aorgazf/cbm4032_rpi/Hardware - REV03F/CBM4032_Pi4_Pi5_IEEE488_REV03.kicad_pcb

## KiCad design Hardware - REV03F/CBM4032_Pi4_Pi5_IEEE488_REV03.kicad_pcb (2026-10-24, last stored version)

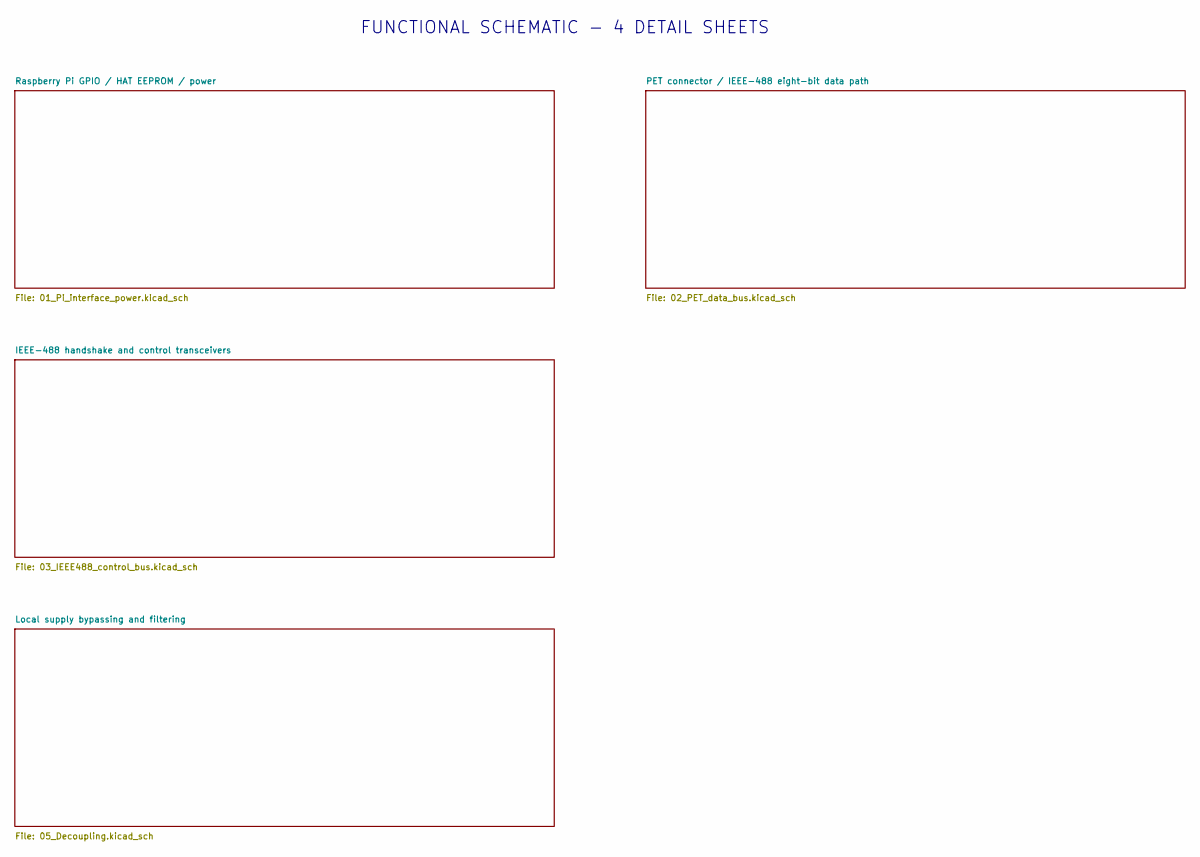
[picture p1: schematic CBM4032_Pi4_Pi5_IEEE488_REV03.kicad_sch, CBM 4032/Pi4B/Pi5 IEEE-488 HAT]

Notes on the sheet:
FUNCTIONAL SCHEMATIC - 4 DETAIL SHEETS

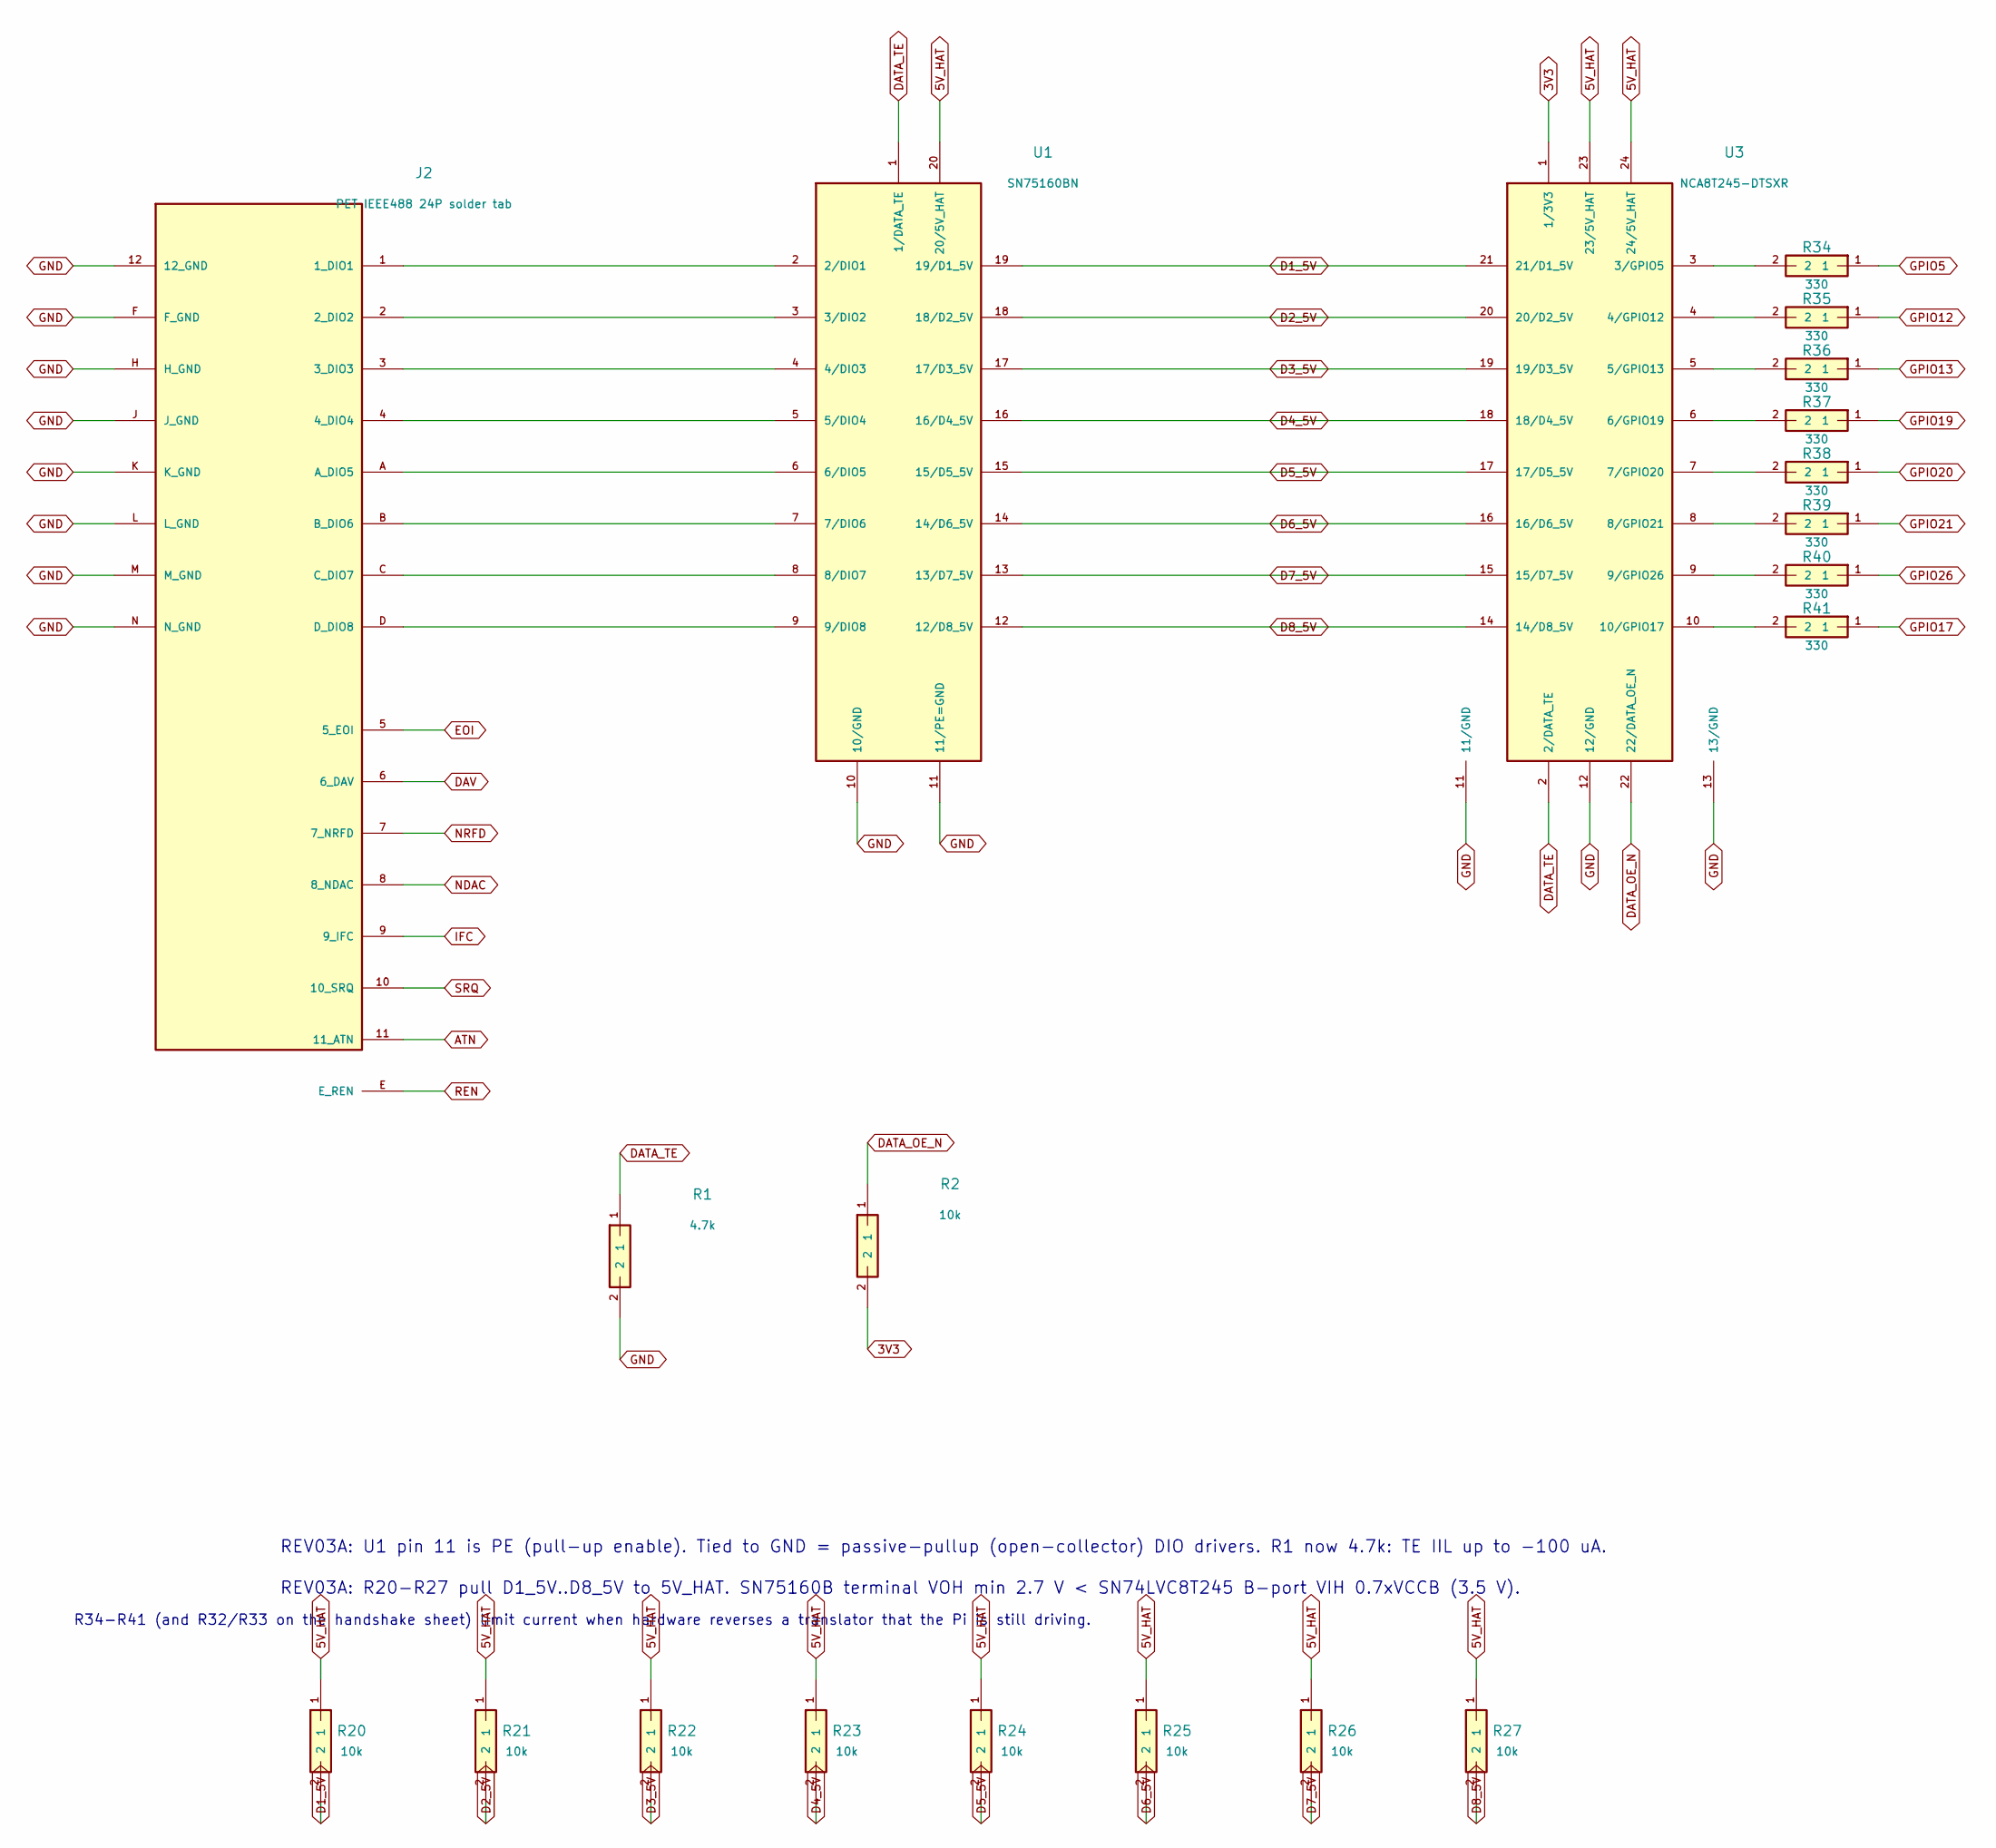
[picture p2: schematic 02_PET_data_bus.kicad_sch, CBM4032 <-> Raspberry Pi IEEE-488 HAT]

Parts:
J2: PET IEEE488 24P solder tab; J2
R1: 4.7k; R0805; MPN 0805W8F4701T5E; LCSC C17673
R2, R20, R21, R22, R23, R24, R25, R26, R27: 10k; R0805; MPN 0805W8F1002T5E; LCSC C17414
R34, R35, R36, R37, R38, R39, R40, R41: 330; R0805; MPN 0805W8F3300T5E; LCSC C17630
U1: SN75160BN; DIP20; MPN SN75160BN
U3: NCA8T245-DTSXR; TSSOP24; MPN NCA8T245-DTSXR; LCSC C40086844

Connections:
3V3: R2.2, U3.1 (1/3V3); also elsewhere on the board
5V_HAT: R20.1, R21.1, R22.1, R23.1, R24.1, R25.1, R26.1, R27.1, U1.20 (20/5V_HAT), U3.23 (23/5V_HAT), U3.24 (24/5V_HAT); also elsewhere on the board
ATN: J2.11 (11_ATN); also elsewhere on the board
D1_5V: R20.2, U1.19 (19/D1_5V), U3.21 (21/D1_5V)
D2_5V: R21.2, U1.18 (18/D2_5V), U3.20 (20/D2_5V)
D3_5V: R22.2, U1.17 (17/D3_5V), U3.19 (19/D3_5V)
D4_5V: R23.2, U1.16 (16/D4_5V), U3.18 (18/D4_5V)
D5_5V: R24.2, U1.15 (15/D5_5V), U3.17 (17/D5_5V)
D6_5V: R25.2, U1.14 (14/D6_5V), U3.16 (16/D6_5V)
D7_5V: R26.2, U1.13 (13/D7_5V), U3.15 (15/D7_5V)
D8_5V: R27.2, U1.12 (12/D8_5V), U3.14 (14/D8_5V)
DATA_OE_N: R2.1, U3.22 (22/DATA_OE_N); also elsewhere on the board
DATA_TE: R1.1, U1.1 (1/DATA_TE), U3.2 (2/DATA_TE); also elsewhere on the board
DAV: J2.6 (6_DAV); also elsewhere on the board
EOI: J2.5 (5_EOI); also elsewhere on the board
GND: J2.12 (12_GND), J2.F (F_GND), J2.H (H_GND), J2.J (J_GND), J2.K (K_GND), J2.L (L_GND), J2.M (M_GND), J2.N (N_GND), R1.2, U1.10 (10/GND), U1.11 (11/PE=GND), U3.11 (11/GND), U3.12 (12/GND), U3.13 (13/GND); also elsewhere on the board
GPIO5: R34.1; also elsewhere on the board
GPIO12: R35.1; also elsewhere on the board
GPIO13: R36.1; also elsewhere on the board
GPIO17: R41.1; also elsewhere on the board
GPIO19: R37.1; also elsewhere on the board
GPIO20: R38.1; also elsewhere on the board
GPIO21: R39.1; also elsewhere on the board
GPIO26: R40.1; also elsewhere on the board
IFC: J2.9 (9_IFC); also elsewhere on the board
NDAC: J2.8 (8_NDAC); also elsewhere on the board
NRFD: J2.7 (7_NRFD); also elsewhere on the board
unnamed: J2.1 (1_DIO1), U1.2 (2/DIO1)
unnamed: J2.2 (2_DIO2), U1.3 (3/DIO2)
unnamed: J2.3 (3_DIO3), U1.4 (4/DIO3)
unnamed: J2.4 (4_DIO4), U1.5 (5/DIO4)
unnamed: J2.A (A_DIO5), U1.6 (6/DIO5)
unnamed: J2.B (B_DIO6), U1.7 (7/DIO6)
unnamed: J2.C (C_DIO7), U1.8 (8/DIO7)
unnamed: J2.D (D_DIO8), U1.9 (9/DIO8)
unnamed: R34.2, U3.3 (3/GPIO5)
unnamed: R35.2, U3.4 (4/GPIO12)
unnamed: R36.2, U3.5 (5/GPIO13)
unnamed: R37.2, U3.6 (6/GPIO19)
unnamed: R38.2, U3.7 (7/GPIO20)
unnamed: R39.2, U3.8 (8/GPIO21)
unnamed: R40.2, U3.9 (9/GPIO26)
unnamed: R41.2, U3.10 (10/GPIO17)
REN: J2.E (E_REN); also elsewhere on the board
SRQ: J2.10 (10_SRQ); also elsewhere on the board

Notes on the sheet:
REV03A: R20-R27 pull D1_5V..D8_5V to 5V_HAT. SN75160B terminal VOH min 2.7 V < SN74LVC8T245 B-port VIH 0.7xVCCB (3.5 V).
R34-R41 (and R32/R33 on the handshake sheet) limit current when hardware reverses a translator that the Pi is still driving.
REV03A: U1 pin 11 is PE (pull-up enable). Tied to GND = passive-pullup (open-collector) DIO drivers. R1 now 4.7k: TE IIL up to -100 uA.

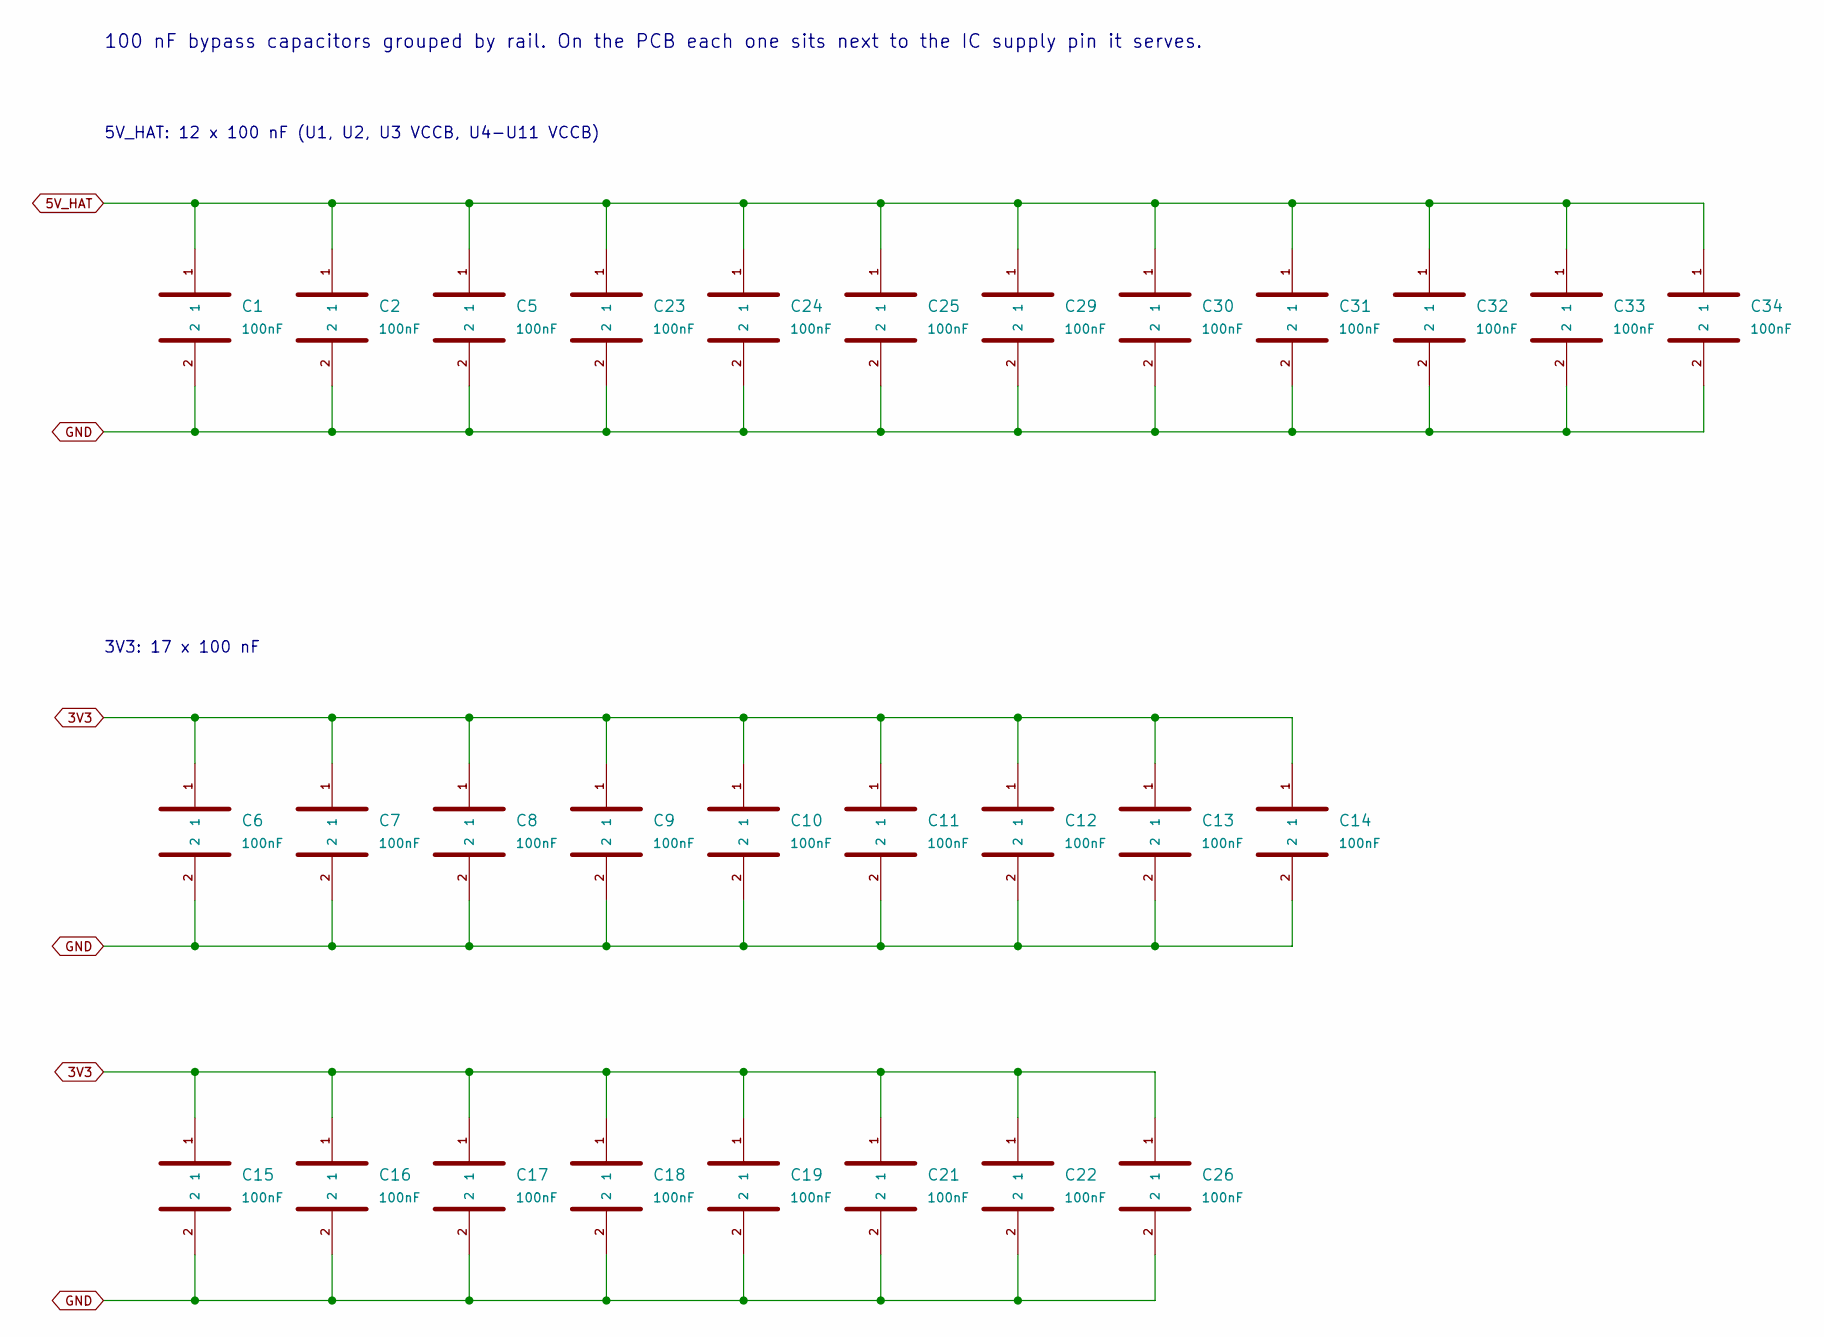
[picture p3: schematic 05_Decoupling.kicad_sch, CBM4032 <-> Raspberry Pi IEEE-488 HAT]

Parts:
C1, C2, C5, C6, C7, C8, C9, C10, C11, C12, C13, C14, C15, C16, C17, C18, C19, C21, C22, C23, C24, C25, C26, C29, C30, C31, C32, C33, C34: 100nF; C0805; MPN CC0805KRX7R9BB104; LCSC C49678

Connections:
3V3: C6.1, C7.1, C8.1, C9.1, C10.1, C11.1, C12.1, C13.1, C14.1, C15.1, C16.1, C17.1, C18.1, C19.1, C21.1, C22.1, C26.1; also elsewhere on the board
5V_HAT: C1.1, C2.1, C5.1, C23.1, C24.1, C25.1, C29.1, C30.1, C31.1, C32.1, C33.1, C34.1; also elsewhere on the board
GND: C1.2, C2.2, C5.2, C6.2, C7.2, C8.2, C9.2, C10.2, C11.2, C12.2, C13.2, C14.2, C15.2, C16.2, C17.2, C18.2, C19.2, C21.2, C22.2, C23.2, C24.2, C25.2, C26.2, C29.2, C30.2, C31.2, C32.2, C33.2, C34.2; also elsewhere on the board

Notes on the sheet:
5V_HAT: 12 x 100 nF (U1, U2, U3 VCCB, U4-U11 VCCB)
100 nF bypass capacitors grouped by rail. On the PCB each one sits next to the IC supply pin it serves.
3V3: 17 x 100 nF

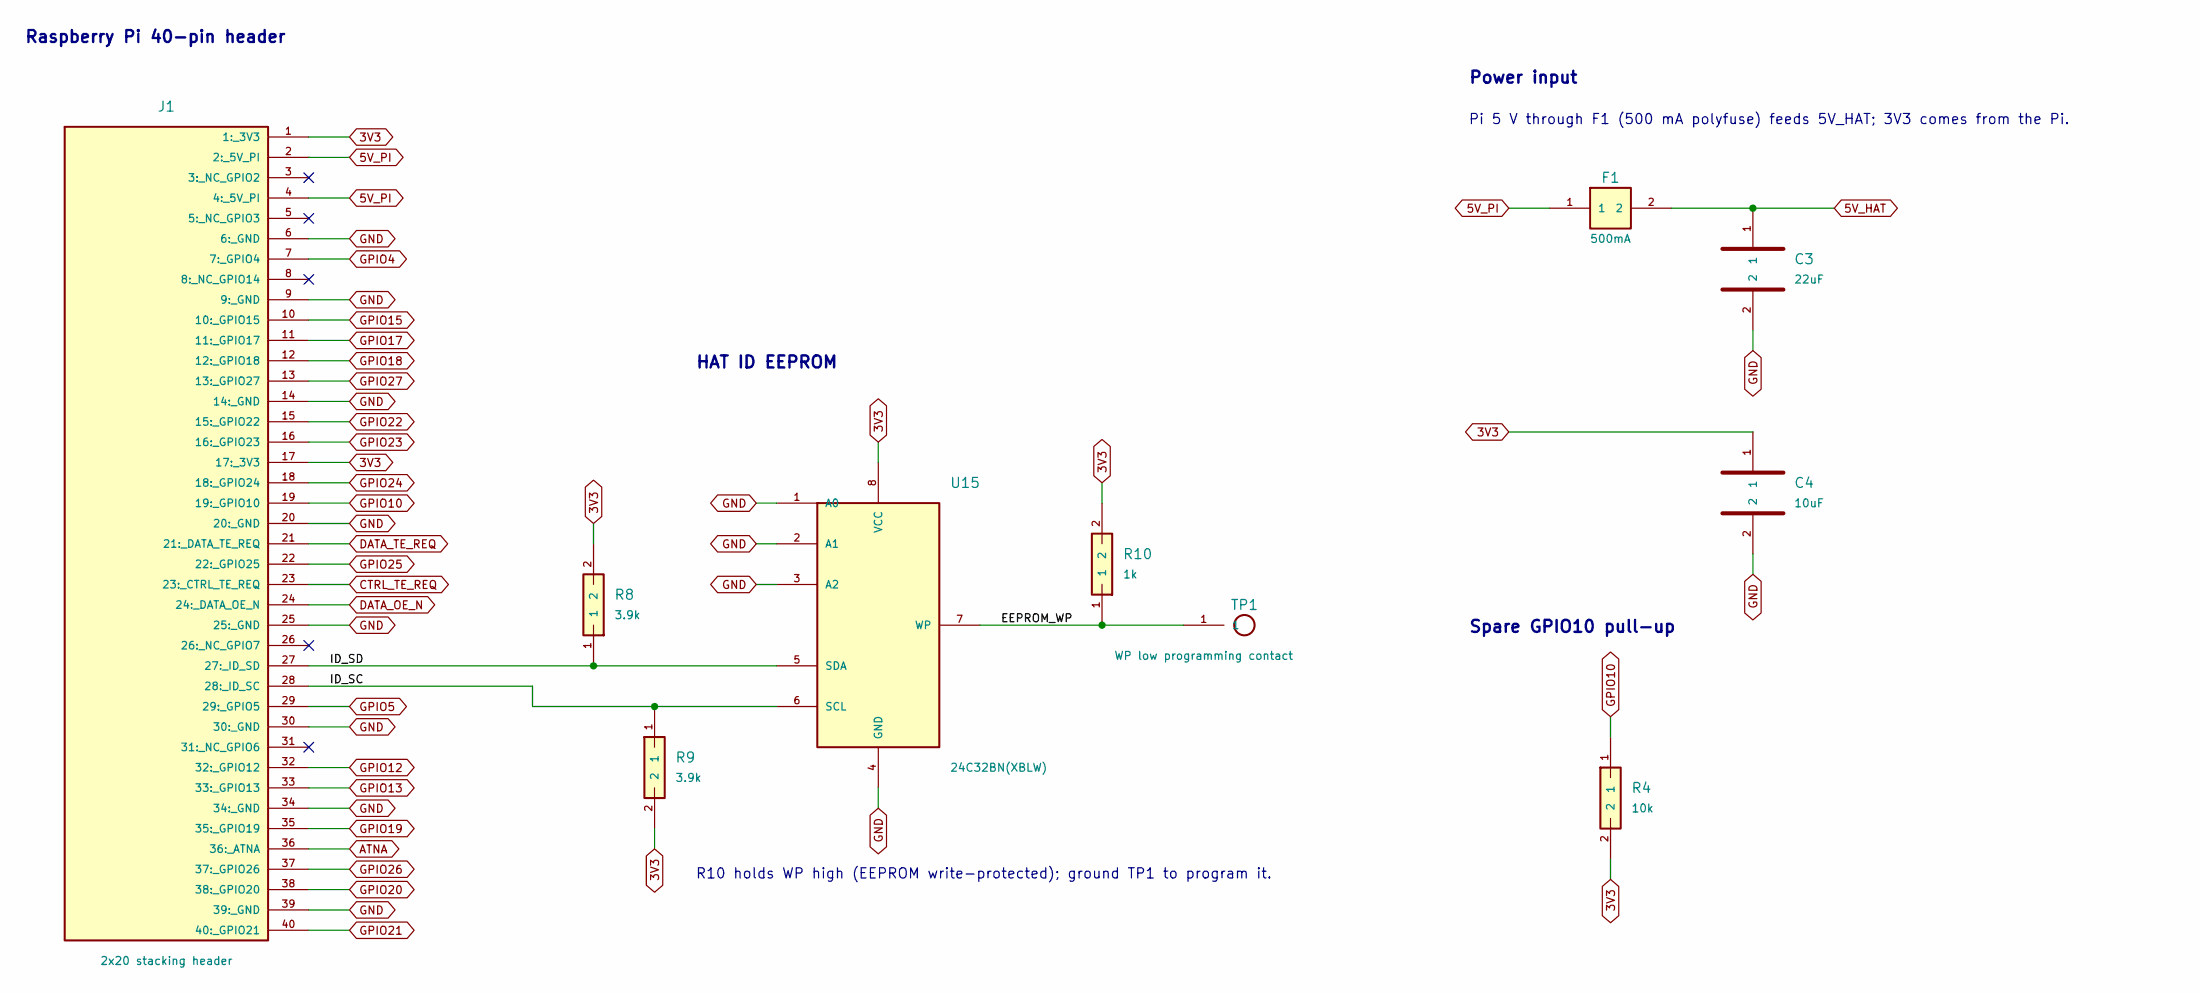
[picture p4: schematic 01_Pi_interface_power.kicad_sch, CBM4032 <-> Raspberry Pi IEEE-488 HAT]

Parts:
C3: 22uF; C1206; MPN CL31A226KAHNNNE; LCSC C12891
C4: 10uF; C0805; MPN CL21A106KAYNNNE; LCSC C15850
F1: 500mA; R1206; MPN 1206L050/6NR; LCSC C7542942
J1: 2x20 stacking header; J1
R4: 10k; R0805; MPN 0805W8F1002T5E; LCSC C17414
R8, R9: 3.9k; R0805; MPN 0805W8F3901T5E; LCSC C17614
R10: 1k; R0805; MPN 0805W8F1001T5E; LCSC C17513
TP1: WP low programming contact; TP
U15: 24C32BN(XBLW); SOP8; MPN 24C32BN(XBLW); LCSC C18723546

Connections:
3V3: C4.1, J1.1 (1:_3V3), J1.17 (17:_3V3), R4.2, R8.2, R9.2, R10.2, U15.8 (VCC); also elsewhere on the board
5V_HAT: C3.1, F1.2; also elsewhere on the board
5V_PI: F1.1, J1.2 (2:_5V_PI), J1.4 (4:_5V_PI)
/Raspberry Pi GPIO / HAT EEPROM / power/EEPROM_WP: R10.1, TP1.1 (1_1), U15.7 (WP)
/Raspberry Pi GPIO / HAT EEPROM / power/ID_SC: J1.28 (28:_ID_SC), R9.1, U15.6 (SCL)
/Raspberry Pi GPIO / HAT EEPROM / power/ID_SD: J1.27 (27:_ID_SD), R8.1, U15.5 (SDA)
ATNA: J1.36 (36:_ATNA); also elsewhere on the board
CTRL_TE_REQ: J1.23 (23:_CTRL_TE_REQ); also elsewhere on the board
DATA_OE_N: J1.24 (24:_DATA_OE_N); also elsewhere on the board
DATA_TE_REQ: J1.21 (21:_DATA_TE_REQ); also elsewhere on the board
GND: C3.2, C4.2, J1.6 (6:_GND), J1.9 (9:_GND), J1.14 (14:_GND), J1.20 (20:_GND), J1.25 (25:_GND), J1.30 (30:_GND), J1.34 (34:_GND), J1.39 (39:_GND), U15.1 (A0), U15.2 (A1), U15.3 (A2), U15.4 (GND); also elsewhere on the board
GPIO4: J1.7 (7:_GPIO4); also elsewhere on the board
GPIO5: J1.29 (29:_GPIO5); also elsewhere on the board
GPIO10: J1.19 (19:_GPIO10), R4.1
GPIO12: J1.32 (32:_GPIO12); also elsewhere on the board
GPIO13: J1.33 (33:_GPIO13); also elsewhere on the board
GPIO15: J1.10 (10:_GPIO15); also elsewhere on the board
GPIO17: J1.11 (11:_GPIO17); also elsewhere on the board
GPIO18: J1.12 (12:_GPIO18); also elsewhere on the board
GPIO19: J1.35 (35:_GPIO19); also elsewhere on the board
GPIO20: J1.38 (38:_GPIO20); also elsewhere on the board
GPIO21: J1.40 (40:_GPIO21); also elsewhere on the board
GPIO22: J1.15 (15:_GPIO22); also elsewhere on the board
GPIO23: J1.16 (16:_GPIO23); also elsewhere on the board
GPIO24: J1.18 (18:_GPIO24); also elsewhere on the board
GPIO25: J1.22 (22:_GPIO25); also elsewhere on the board
GPIO26: J1.37 (37:_GPIO26); also elsewhere on the board
GPIO27: J1.13 (13:_GPIO27); also elsewhere on the board

Notes on the sheet:
Pi 5 V through F1 (500 mA polyfuse) feeds 5V_HAT; 3V3 comes from the Pi.
Spare GPIO10 pull-up
R10 holds WP high (EEPROM write-protected); ground TP1 to program it.
Raspberry Pi 40-pin header
Power input
HAT ID EEPROM
