aorgazf/cbm4032_rpi/Hardware - REV03F/CBM4032_Pi4_Pi5_IEEE488_REV03.kicad_pcb

## KiCad design Hardware - REV03F/CBM4032_Pi4_Pi5_IEEE488_REV03.kicad_pcb (continued)

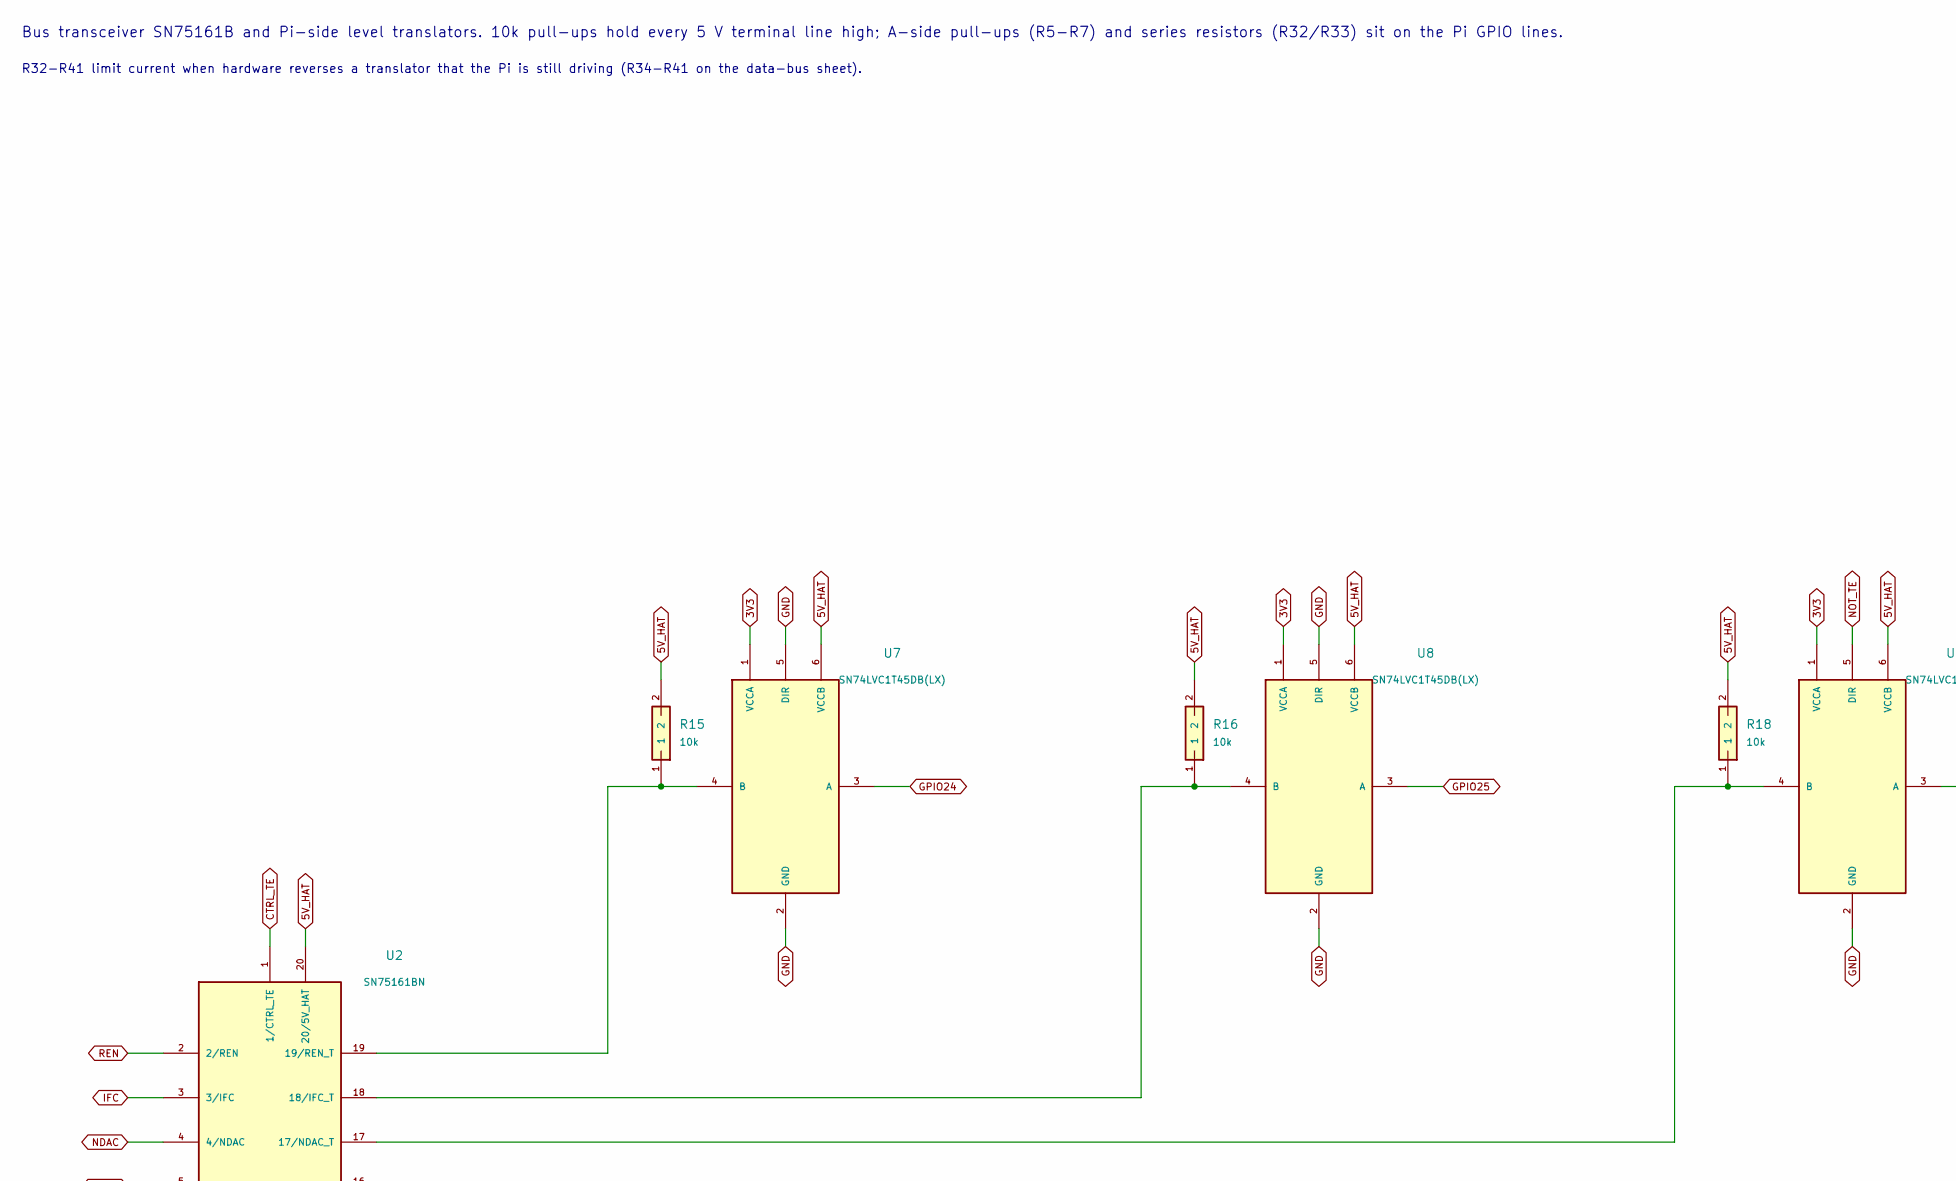
[picture p5: schematic 03_IEEE488_control_bus.kicad_sch, CBM4032 <-> Raspberry Pi IEEE-488 HAT - IEEE-488 handshake …, part in row 1, column 1]

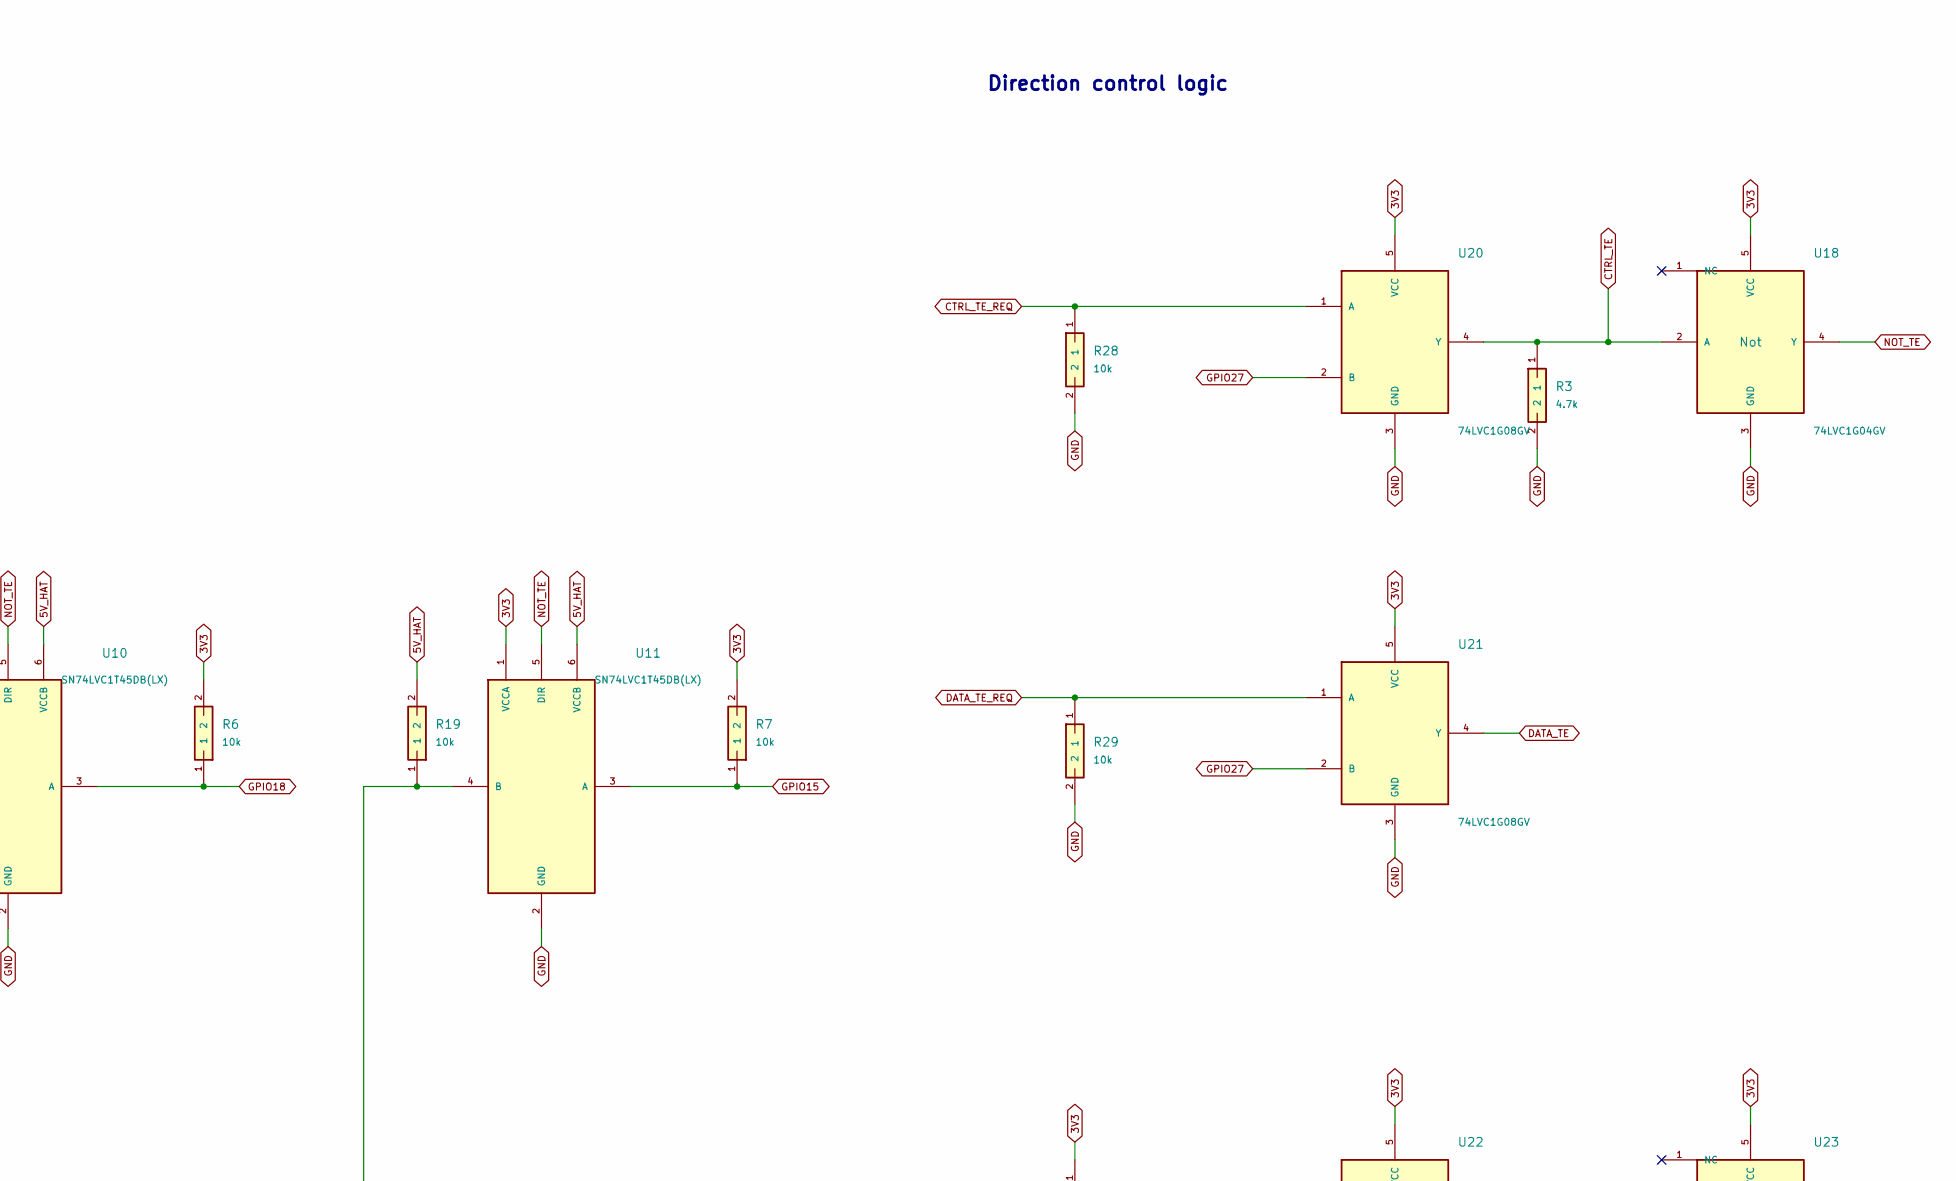
[picture p6: schematic 03_IEEE488_control_bus.kicad_sch, CBM4032 <-> Raspberry Pi IEEE-488 HAT - IEEE-488 handshake …, part in row 1, column 2]

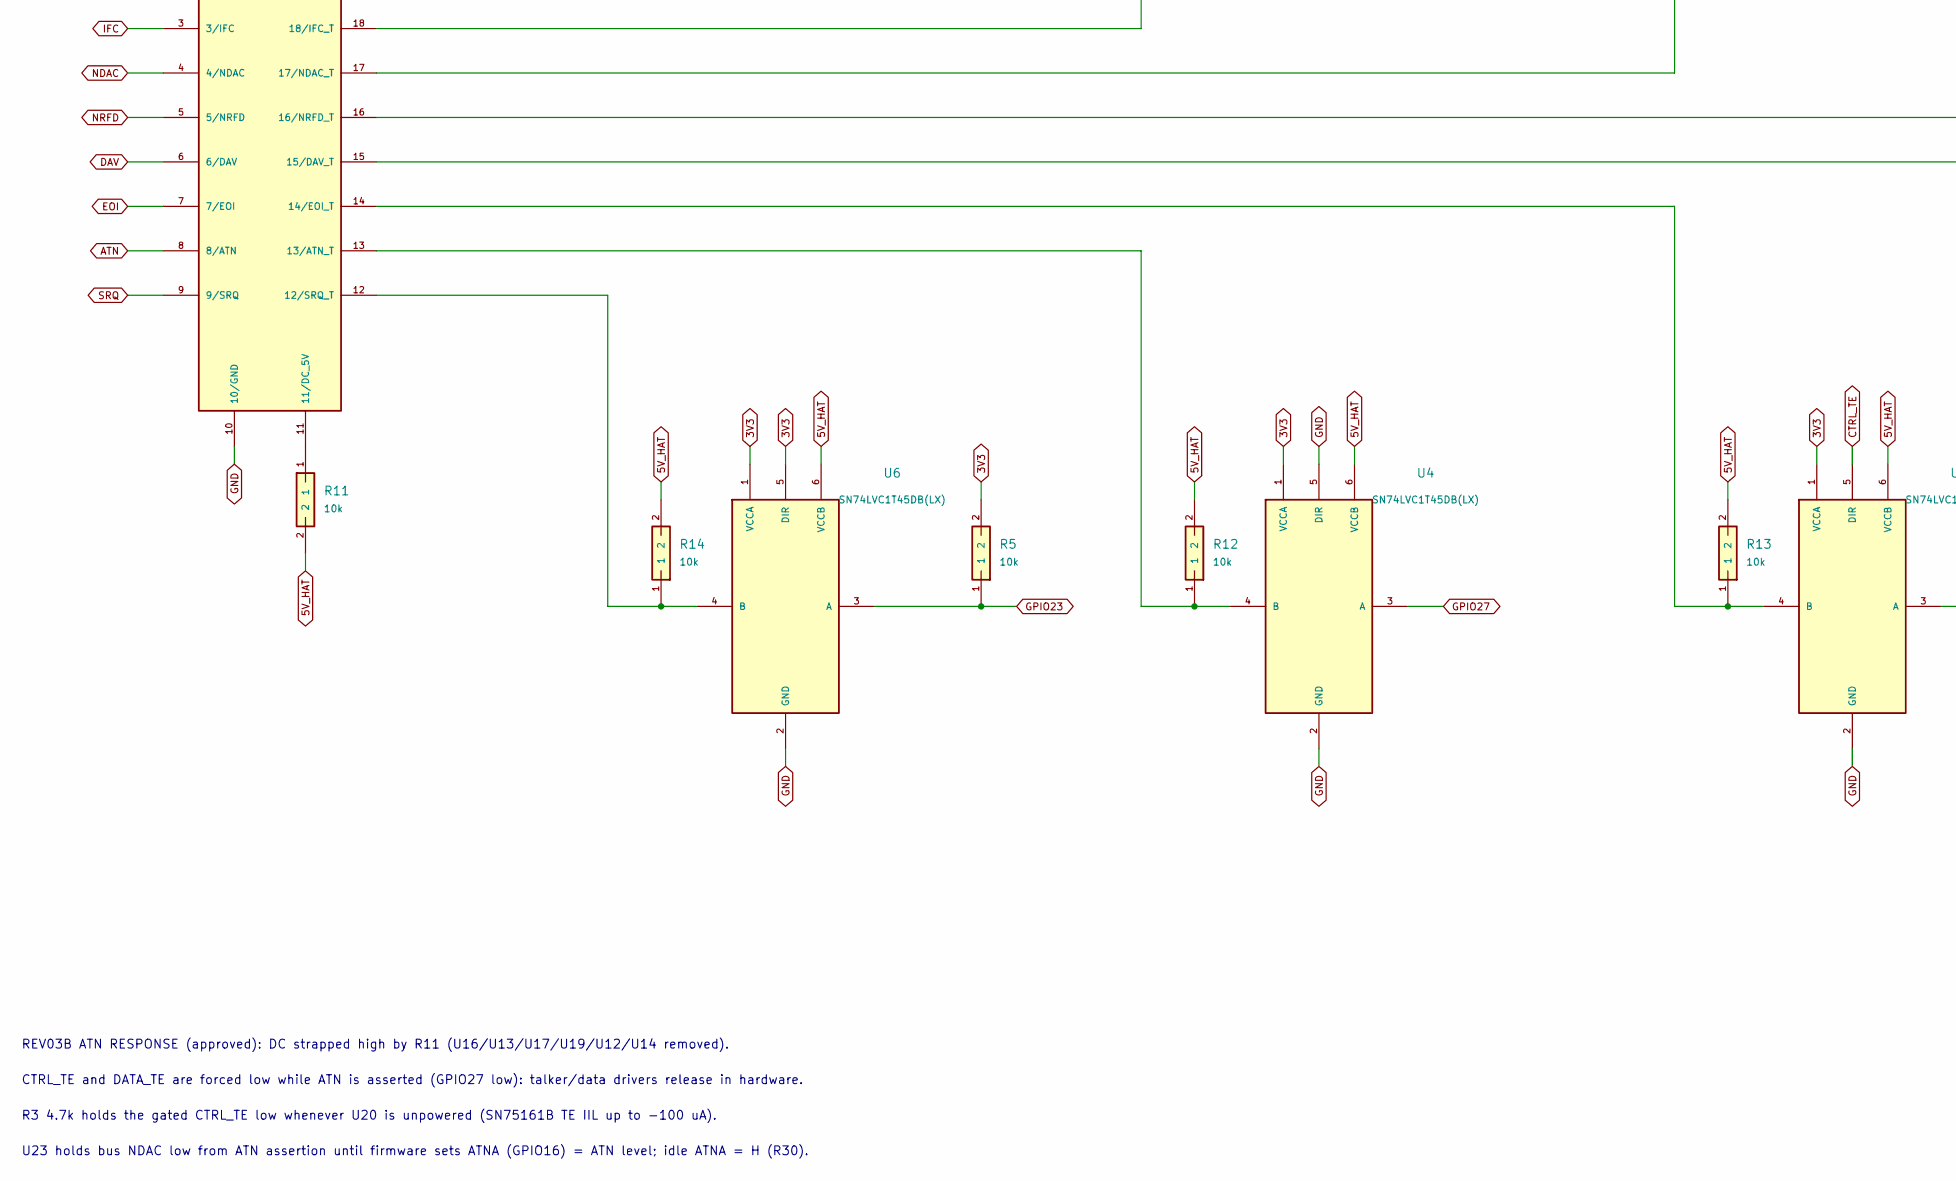
[picture p7: schematic 03_IEEE488_control_bus.kicad_sch, CBM4032 <-> Raspberry Pi IEEE-488 HAT - IEEE-488 handshake …, part in row 2, column 1]

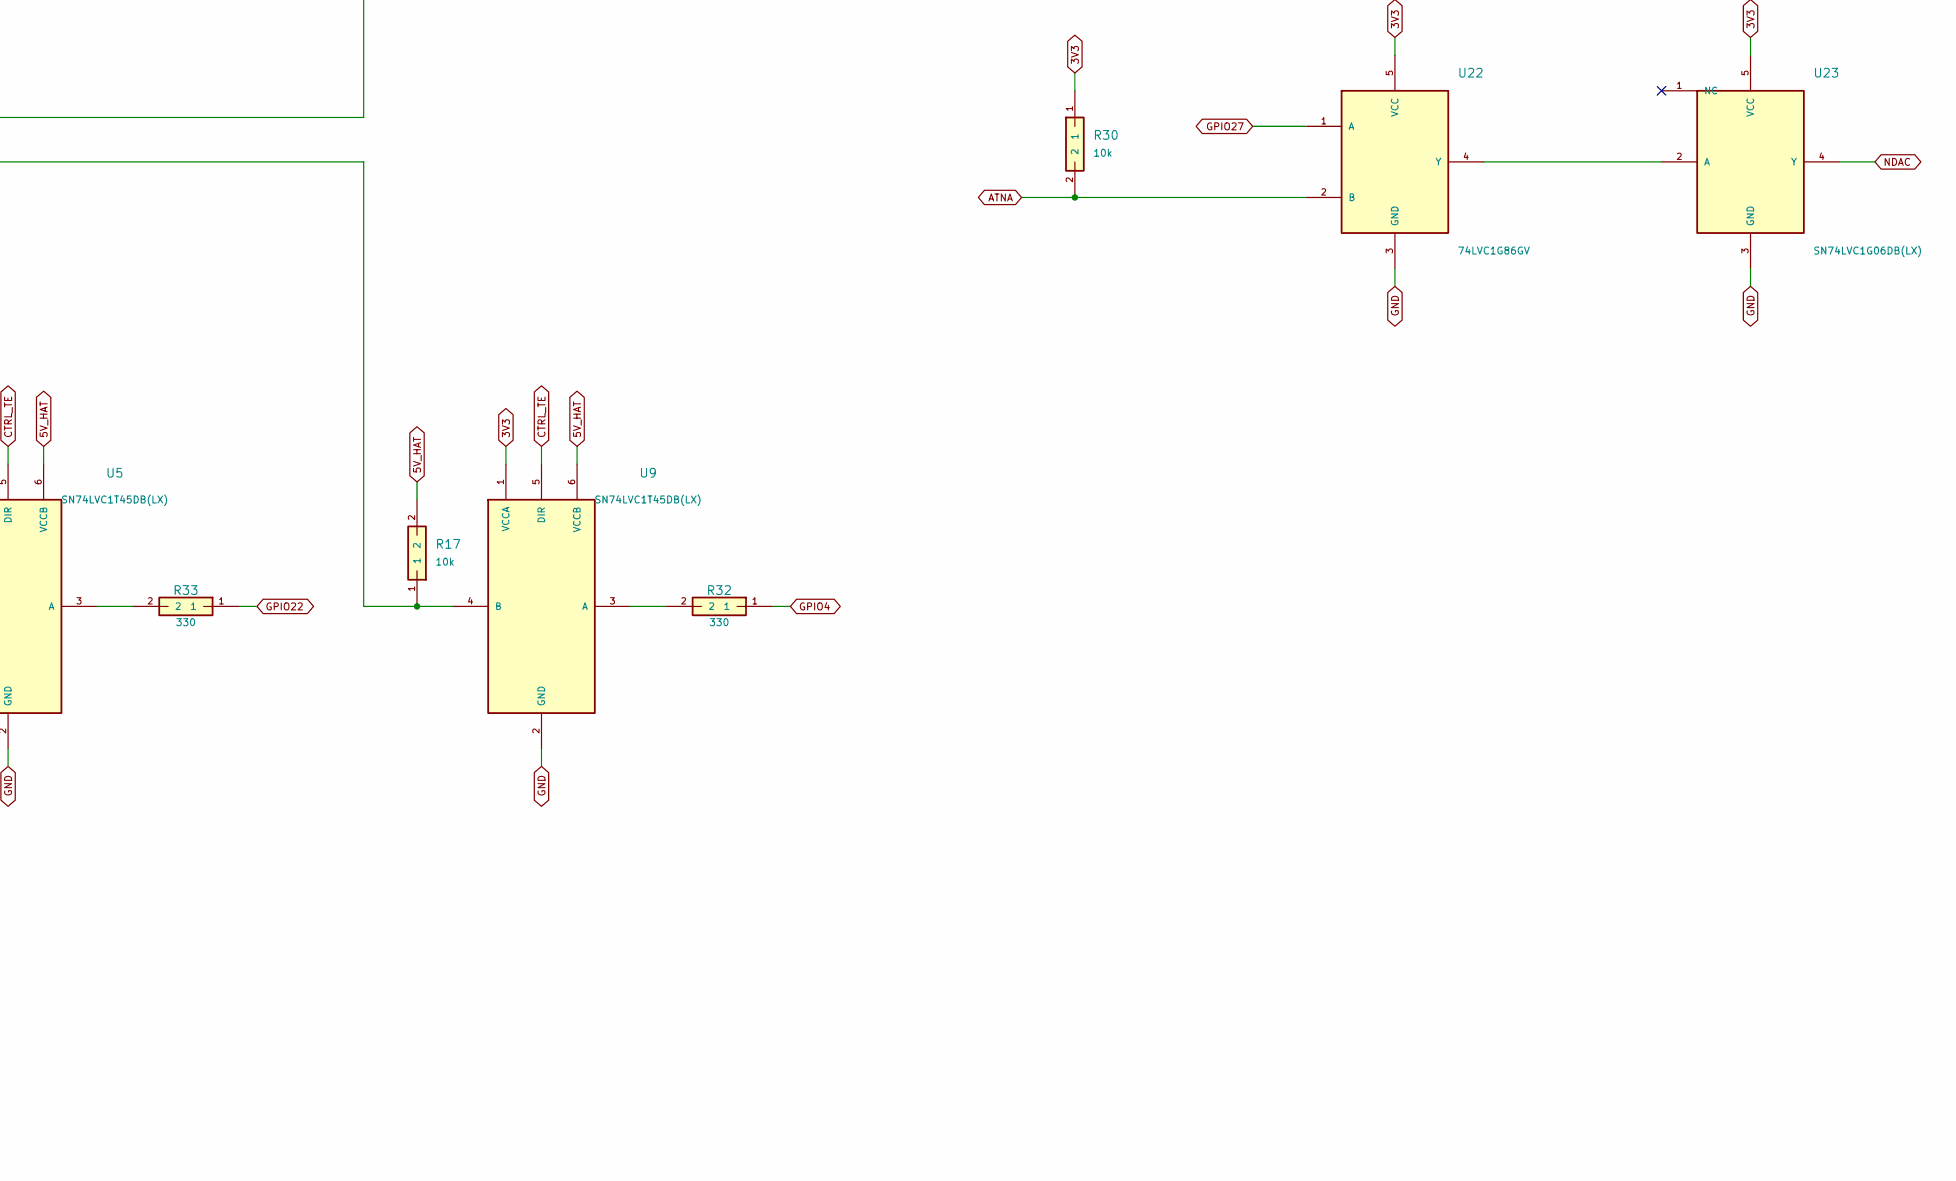
[picture p8: schematic 03_IEEE488_control_bus.kicad_sch, CBM4032 <-> Raspberry Pi IEEE-488 HAT - IEEE-488 handshake …, part in row 2, column 2]

Parts:
R3: 4.7k; R0805; MPN 0805W8F4701T5E; LCSC C17673
R5, R6, R7, R11, R12, R13, R14, R15, R16, R17, R18, R19, R28, R29, R30: 10k; R0805; MPN 0805W8F1002T5E; LCSC C17414
R32, R33: 330; R0805; MPN 0805W8F3300T5E; LCSC C17630
U2: SN75161BN; DIP20; MPN SN75161BN
U4, U5, U6, U7, U8, U9, U10, U11: SN74LVC1T45DB(LX); SOT23_6; MPN SN74LVC1T45DB(LX); LCSC C22469931
U18: 74LVC1G04GV; SOT23_5; MPN 74LVC1G04GV; LCSC C19829589
U20, U21: 74LVC1G08GV; SOT23_5; MPN 74LVC1G08GV; LCSC C19829591
U22: 74LVC1G86GV; SOT23_5; MPN 74LVC1G86GV; LCSC C19829595
U23: SN74LVC1G06DB(LX); SOT23_5; MPN SN74LVC1G06DB(LX); LCSC C22469967

Connections:
3V3: R5.2, R6.2, R7.2, R30.1, U4.1 (VCCA), U5.1 (VCCA), U6.1 (VCCA), U6.5 (DIR), U7.1 (VCCA), U8.1 (VCCA), U9.1 (VCCA), U10.1 (VCCA), U11.1 (VCCA), U18.5 (VCC), U20.5 (VCC), U21.5 (VCC), U22.5 (VCC), U23.5 (VCC); also elsewhere on the board
5V_HAT: R11.2, R12.2, R13.2, R14.2, R15.2, R16.2, R17.2, R18.2, R19.2, U2.20 (20/5V_HAT), U4.6 (VCCB), U5.6 (VCCB), U6.6 (VCCB), U7.6 (VCCB), U8.6 (VCCB), U9.6 (VCCB), U10.6 (VCCB), U11.6 (VCCB); also elsewhere on the board
ATN: U2.8 (8/ATN); also elsewhere on the board
ATNA: R30.2, U22.2 (B); also elsewhere on the board
CTRL_TE: R3.1, U2.1 (1/CTRL_TE), U5.5 (DIR), U9.5 (DIR), U18.2 (A), U20.4 (Y)
CTRL_TE_REQ: R28.1, U20.1 (A); also elsewhere on the board
DATA_TE: U21.4 (Y); also elsewhere on the board
DATA_TE_REQ: R29.1, U21.1 (A); also elsewhere on the board
DAV: U2.6 (6/DAV); also elsewhere on the board
EOI: U2.7 (7/EOI); also elsewhere on the board
GND: R3.2, R28.2, R29.2, U2.10 (10/GND), U4.2 (GND), U4.5 (DIR), U5.2 (GND), U6.2 (GND), U7.2 (GND), U7.5 (DIR), U8.2 (GND), U8.5 (DIR), U9.2 (GND), U10.2 (GND), U11.2 (GND), U18.3 (GND), U20.3 (GND), U21.3 (GND), U22.3 (GND), U23.3 (GND); also elsewhere on the board
GPIO4: R32.1; also elsewhere on the board
GPIO15: R7.1, U11.3 (A); also elsewhere on the board
GPIO18: R6.1, U10.3 (A); also elsewhere on the board
GPIO22: R33.1; also elsewhere on the board
GPIO23: R5.1, U6.3 (A); also elsewhere on the board
GPIO24: U7.3 (A); also elsewhere on the board
GPIO25: U8.3 (A); also elsewhere on the board
GPIO27: U4.3 (A), U20.2 (B), U21.2 (B), U22.1 (A); also elsewhere on the board
IFC: U2.3 (3/IFC); also elsewhere on the board
NDAC: U2.4 (4/NDAC), U23.4 (Y); also elsewhere on the board
NOT_TE: U10.5 (DIR), U11.5 (DIR), U18.4 (Y)
NRFD: U2.5 (5/NRFD); also elsewhere on the board
unnamed: R11.1, U2.11 (11/DC_5V)
unnamed: R14.1, U2.12 (12/SRQ_T), U6.4 (B)
unnamed: R12.1, U2.13 (13/ATN_T), U4.4 (B)
unnamed: R13.1, U2.14 (14/EOI_T), U5.4 (B)
unnamed: R17.1, U2.15 (15/DAV_T), U9.4 (B)
unnamed: R16.1, U2.18 (18/IFC_T), U8.4 (B)
unnamed: R15.1, U2.19 (19/REN_T), U7.4 (B)
unnamed: R33.2, U5.3 (A)
unnamed: R32.2, U9.3 (A)
unnamed: R18.1, U2.17 (17/NDAC_T), U10.4 (B)
unnamed: R19.1, U2.16 (16/NRFD_T), U11.4 (B)
unnamed: U22.4 (Y), U23.2 (A)
REN: U2.2 (2/REN); also elsewhere on the board
SRQ: U2.9 (9/SRQ); also elsewhere on the board

Notes on the sheet:
Bus transceiver SN75161B and Pi-side level translators. 10k pull-ups hold every 5 V terminal line high; A-side pull-ups (R5-R7) and series resistors (R32/R33) sit on the Pi GPIO lines.
R3 4.7k holds the gated CTRL_TE low whenever U20 is unpowered (SN75161B TE IIL up to -100 uA).
REV03B ATN RESPONSE (approved): DC strapped high by R11 (U16/U13/U17/U19/U12/U14 removed).
U23 holds bus NDAC low from ATN assertion until firmware sets ATNA (GPIO16) = ATN level; idle ATNA = H (R30).
Direction control logic
R32-R41 limit current when hardware reverses a translator that the Pi is still driving (R34-R41 on the data-bus sheet).
CTRL_TE and DATA_TE are forced low while ATN is asserted (GPIO27 low): talker/data drivers release in hardware.

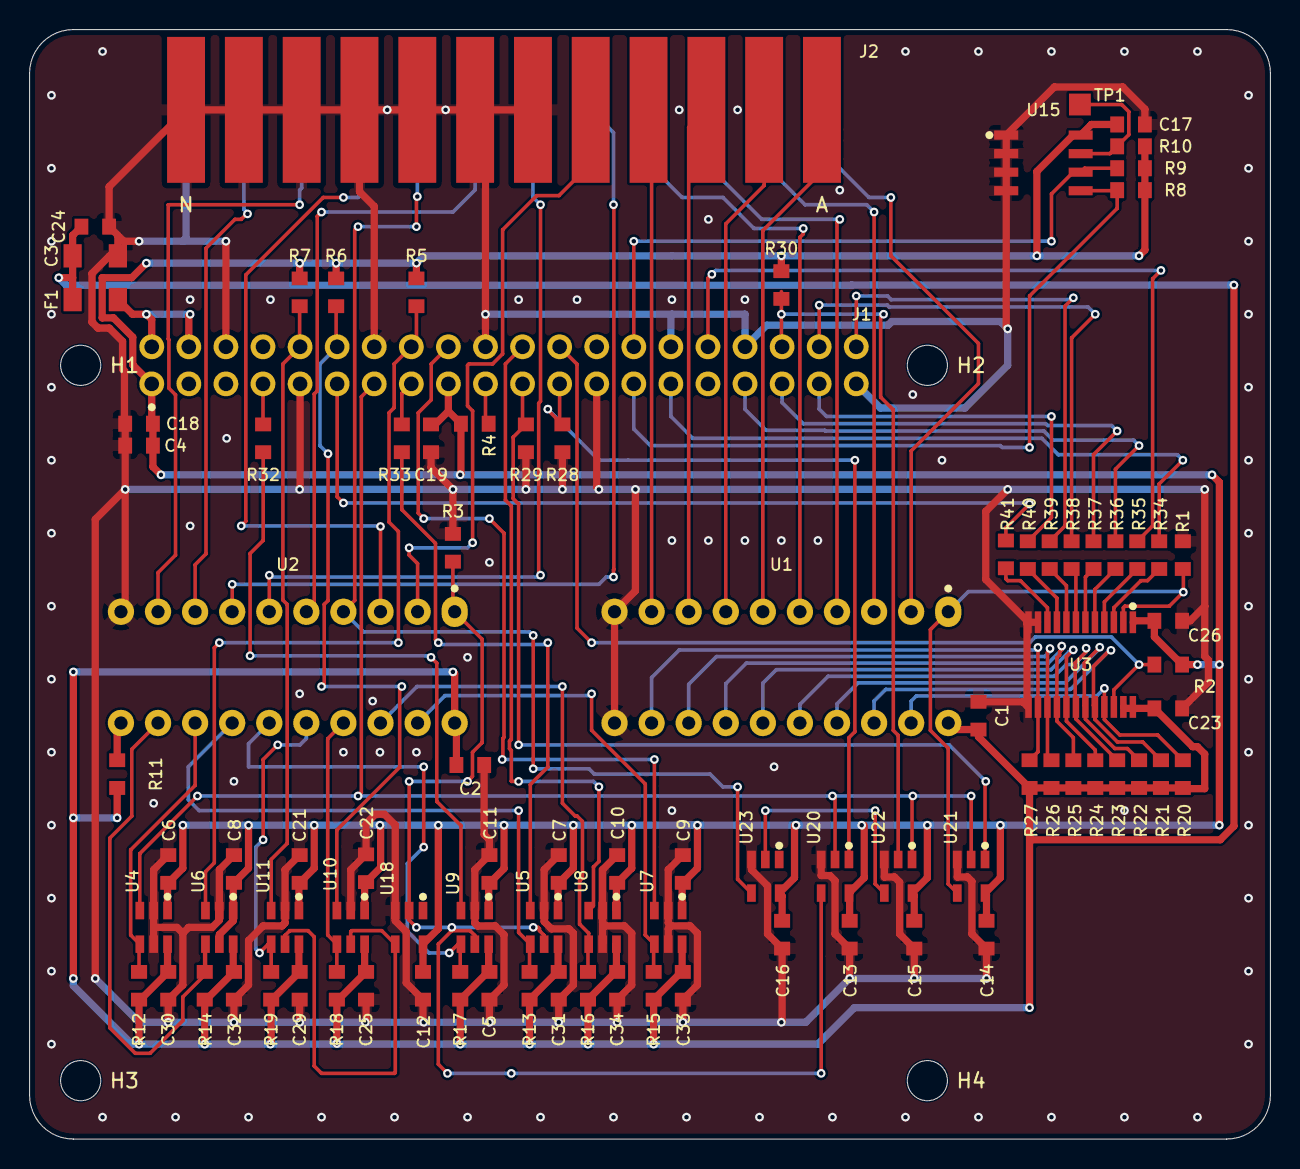
[picture p9: board CBM4032_Pi4_Pi5_IEEE488_REV03.kicad_pcb from above]

Board: 2 copper layers, 85.0 x 76.0 mm, 96 parts (0 on the bottom side), 75 nets.

Other parts of the board:
H1, H2, H3, H4: MountingHole_2.75_NPTH
