aorgazf/cbm4032_rpi/(commit log)

2026-10-24 remove hardware
    [01_Pi_interface_power.kicad_sch, 02_PET_data_bus.kicad_sch, 03_IEEE488_control_bus.kicad_sch, 05_Decoupling.kicad_sch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]
2026-10-24 Make the bus core pass hat_bench on the Pi 5 RT kernel
    Stage 3A showed the documented boot settings were not enough: the stock
    kernel ignores nohz_full/rcu_nocbs, and on the PREEMPT_RT kernel the
    bus thread starved rcuc/ktimers (RCU stalls) while idle CPUs handed
    their driver-poll timers to CPU 3, giving 30-80 us gaps.
    - boot/README.md: RT kernel (linux-image-rpi-v8-rt), cmdline
    isolcpus=3 rcutree.kthread_prio=81 nohz=off, why each is needed,
    measured results and the remaining under-load limit
    - config.txt.snippet: kernel=kernel8_rt.img
    - boot/rt_setup.sh, installed as hat_rt_setup: RT throttling off,
    performance governor, vm.stat_interval, workqueue mask, and
    ktimers/rcuc on the bu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
    [hat_bench.c, hat_monitor.c, rt_util.c, rt_util.h]
2026-10-24 Require a PREEMPT_RT + NO_HZ_FULL kernel and drop Pi 4 support
    The Raspberry Pi RT kernel has no NO_HZ_FULL, so CPU 3 kept its tick.
    Under combined load on the other cores the tick handler slowed to
    20-25 us and hat_bench saw 39-51 us gaps. With a kernel built with
    NO_HZ_FULL and RCU_NOCB_CPU the same 5 min load test peaks at 11.9 us,
    and idle runs at about 6 us.
    - boot/build_kernel.sh: build rpi-6.18.y from the packaged RT config
    plus NO_HZ_FULL/RCU_NOCB_CPU, install kernel8_rtnohz.img, its
    initramfs and modules
    - boot/README.md, config.txt.snippet: use that kernel with
    isolcpus=3 nohz_full=3 rcu_nocbs=3 rcutree.kthread_prio=81;
    nohz=off is no longer wanted (it disables nohz_full)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
    [gpio_backend.c, gpio_backend.h, hat_monitor.c, hat_safe.c, hat_selftest.c, rt_util.c, rt_util.h]
2026-10-24 Add bring-up test plan for CBM 4032 IEEE-488 HAT and update boot configuration files
    [config.txt]
2026-10-27 Read unclaimed RP1 pins in hat_selftest; record bring-up results
    hat_selftest read the bus before claiming any pin. On RP1 a pin that
    config.txt leaves unconfigured (ATN, REN, IFC, DAV, EOI, GPIO10) has no
    funcsel and reads 0, so 3B.4 refused to run with "the HAT looks plugged
    into a PET", and --read-only would have shown the same false levels.
    - gpio backend: claim_inputs() claims, as inputs, only pins nothing has
    claimed yet; safe on a live bus and with another program running
    - hat_selftest: call it for the HAT pins and GPIO10 right after open
    - simulator: like RP1, pins outside the config.txt gpio= lines read 0
    until claimed, so make test now catches this (it reproduced the
    failur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
    [gpio_backend.h, gpio_rp1.c, gpio_sim.c, gpio_sim.h, hat_selftest.c]
2026-10-27 Add bring-up handover for the software team
    Decisions, Pi setup, measured findings from the hardware tests (PET
    handshake timeout ~65 ms, 1.00 us listener ack, RP1 unclaimed pins read
    0), rules for the Stage 2 software and open items.
